Am0k-GIT/Falcon/Hardware/BOM_Falcon.csv

Name | Designator | Footprint | Quantity
 | Inductors:
1uH | L101,L104,L105 | L0805 | 3
33uH | L102,L103 | IND-SMD_L7.3-W6.6 | 2
 | Capacitors:
12pF | C216,C217 | C0603 | 2
22pF | C214,C215 | C0603 | 2
10nF | C105,C110,C202,C204,C206 | C0603 | 5
100nF | C101,C102,C106,C111,C113,C115,C116,C119, C201,C203,C205,C211,C218,C401,C402,C403,C404,C405,C406,C407, C501,C502,C503,C504,C601,C602,C701,C703,C705,C707,C709 | C0603 | 31
0.1uF | C118,C702,C704,C706,C708,C710 | C0805 | 6
1uF | C120,C208,C212 | C0805 | 3
2.2uF | C209,C210 | C0805 | 2
4.7uF | C103,C104,C108,C109 | C0805 | 4
68uF | C112,C114,C207 | CASE-B 3528 | 3
220uF/16V | C107 | SMD W6.3MM | 1
100uF/35V | C711,C712,C713 | CAP-TH W6.3MM | 3
680uF/35V | C117 | CAP-TH W10.0MM | 1
 | Resistors:
100Ω | R401,R402 | 8P4R-0603 | 2
10Ω | R601,R602,R607,R609,R613,R615 | R0805 | 6
20Ω | R103,R104,R303 | R0805 | 3
100Ω | R617,R618,R701,R702,R703,R704,R705,R706,R707,R708,R709,R710, R711,R712 | R0805 | 4
470Ω | R505,R510 | R0805 | 2
510Ω | R417,R418 | R0805 | 2
1kΩ | R403,R405,R407,R409,R411,R413,R419,R503,R508,R713 | R0805 | 9
1.8kΩ | R106 | R0805 | 1
3.9kΩ | R108 | R0805 | 1
4.7kΩ | R301,R302,R511,R512 | R0805 | 4
5.1kΩ | R101,R102,R404,R406,R408,R410,R412,R414,R415,R416 | R0805 | 10
10kΩ | R201,R202,R204,R603,R604 | R0805 | 2
12kΩ | R107 | R0805 | 1
15kΩ | R504,R509 | R0805 | 2
16kΩ | R105 | R0805 | 1
20kΩ | R109 | R0805 | 1
22kΩ | R501,R502,R506,R507 | R0805 | 4
100kΩ | R605,R606,R608,R610,R611,R612,R614,R616 | R0805 | 8
1MΩ | R203 | R0805 | 1
 | Oscillators:
8M | XTAL1 | X2-SMD-5.0X3.2X1.3MM | 1
32.768K | XTAL2 | CRYSTAL-TH_BD3.0-P1.10-D0.4 | 1
 | Diodes:
SS34 | D101,D102,D103,D104 | SMA | 4
PESD3V3L1UA | D501,D502 | SOD-323 | 2
SMD LED | LED1 | LED1206 | 1
 | Transistors:
IRLML6402TRPBF | Q1 | SOT-23-3 | 1
IRF7341TRPBF | Q2 | SOP-8 | 1
IRLR024NTRLPBF | Q3,Q4,Q5 | DPAK | 3
IRLS3034PBF | Q6 | D2PAK | 1
 | Fuses:
12A | F01 | FUSE-SMD_L6.1-W2.7 | 1
2A | F02 | FUSE-SMD_L6.1-W2.7 | 1
1206-0.5A | F03 | F1206 | 1
1206-0.2A | F04 | F1206 | 1
 | Buttons:
SMD SWITCH BUTTON | RST, BOOT0 | SWITCH SMD 4X3MM 4PIN 700955694179 | 2
 | Chips:
USBLC6-2SC6 | U1 | SOT-23-6 | 1
TPS5430DDAR | U2,U3 | ESOP-8 | 2
LM1117-3.3 | U4 | LM1117-3.3 | 1
AT24C32 | U6 | SOP-8 | 1
TLP281-4 | U7,U8 | SMD-16_L10.3-W4.4-P1.27-LS7.0-BL | 2
MC33152DR2G | U10,U11 | SOIC-8 | 2
A4988 | U12,U13,U14,U15,U16 | A4988 | 5
STM32F407VET6 | U5 | LQFP-100 | 1
TPMCP6022 | U9 | SOP-8 | 1
 | Connectors:
USB-TYPE-C-16PIN | USB | TYPE-C-SMD_HX-TYPE-C-16PIN | 1
JST-XH2.54-2PINS | 12V,F0,F1 | CON-XH2.54-2PIN | 3
JST-XH2.54-4PINS | A,B,X,Y,Z | CON-XH2.54-4PIN | 5
JST-PH2.0-2PINS | PT/1,PT/2,TR/1,TR/2,TTL0,TTL1 | CON-PH2.0-2PIN | 6
JST-PH2.0-3PINS | AL,BL,FILAM.,PS_ON,XL,YL,ZL | CON-PH2.0-3PIN | 7
JST-PH2.0-4PINS | CAN,I2C,PROBE | CON-PH2.0-4PIN | 3
KF7.62-2P | PWR | CONN-TH_KF7.62-2P | 1
KF202-5.0-2P | CH0 | CONN-TH_P5.00_KF202-5.0-2P | 1
KF128-5.0-2P | CH1,CH2,CH3 | CONN-TH_P5.00_KF128-5.0-2P | 3
BH-10 | EXP1,EXP2 | BH-10_ATMEL | 2
Header-Male-1.27 2x5 | JP1,JP2,JP3,JP4,JP5 | 2X5-1.27 | 5
Header-Male-1.27 1x3 | P1,P2,P3,P4 | 1X3-1.27 | 4
Header-Male-1.27 1X4 | PROG | 1X4-1.27 | 1
