Am0k-GIT/Falcon/Hardware/BOARD_PREVIEW.pdf

## NPN NC

PWR | NPN NC

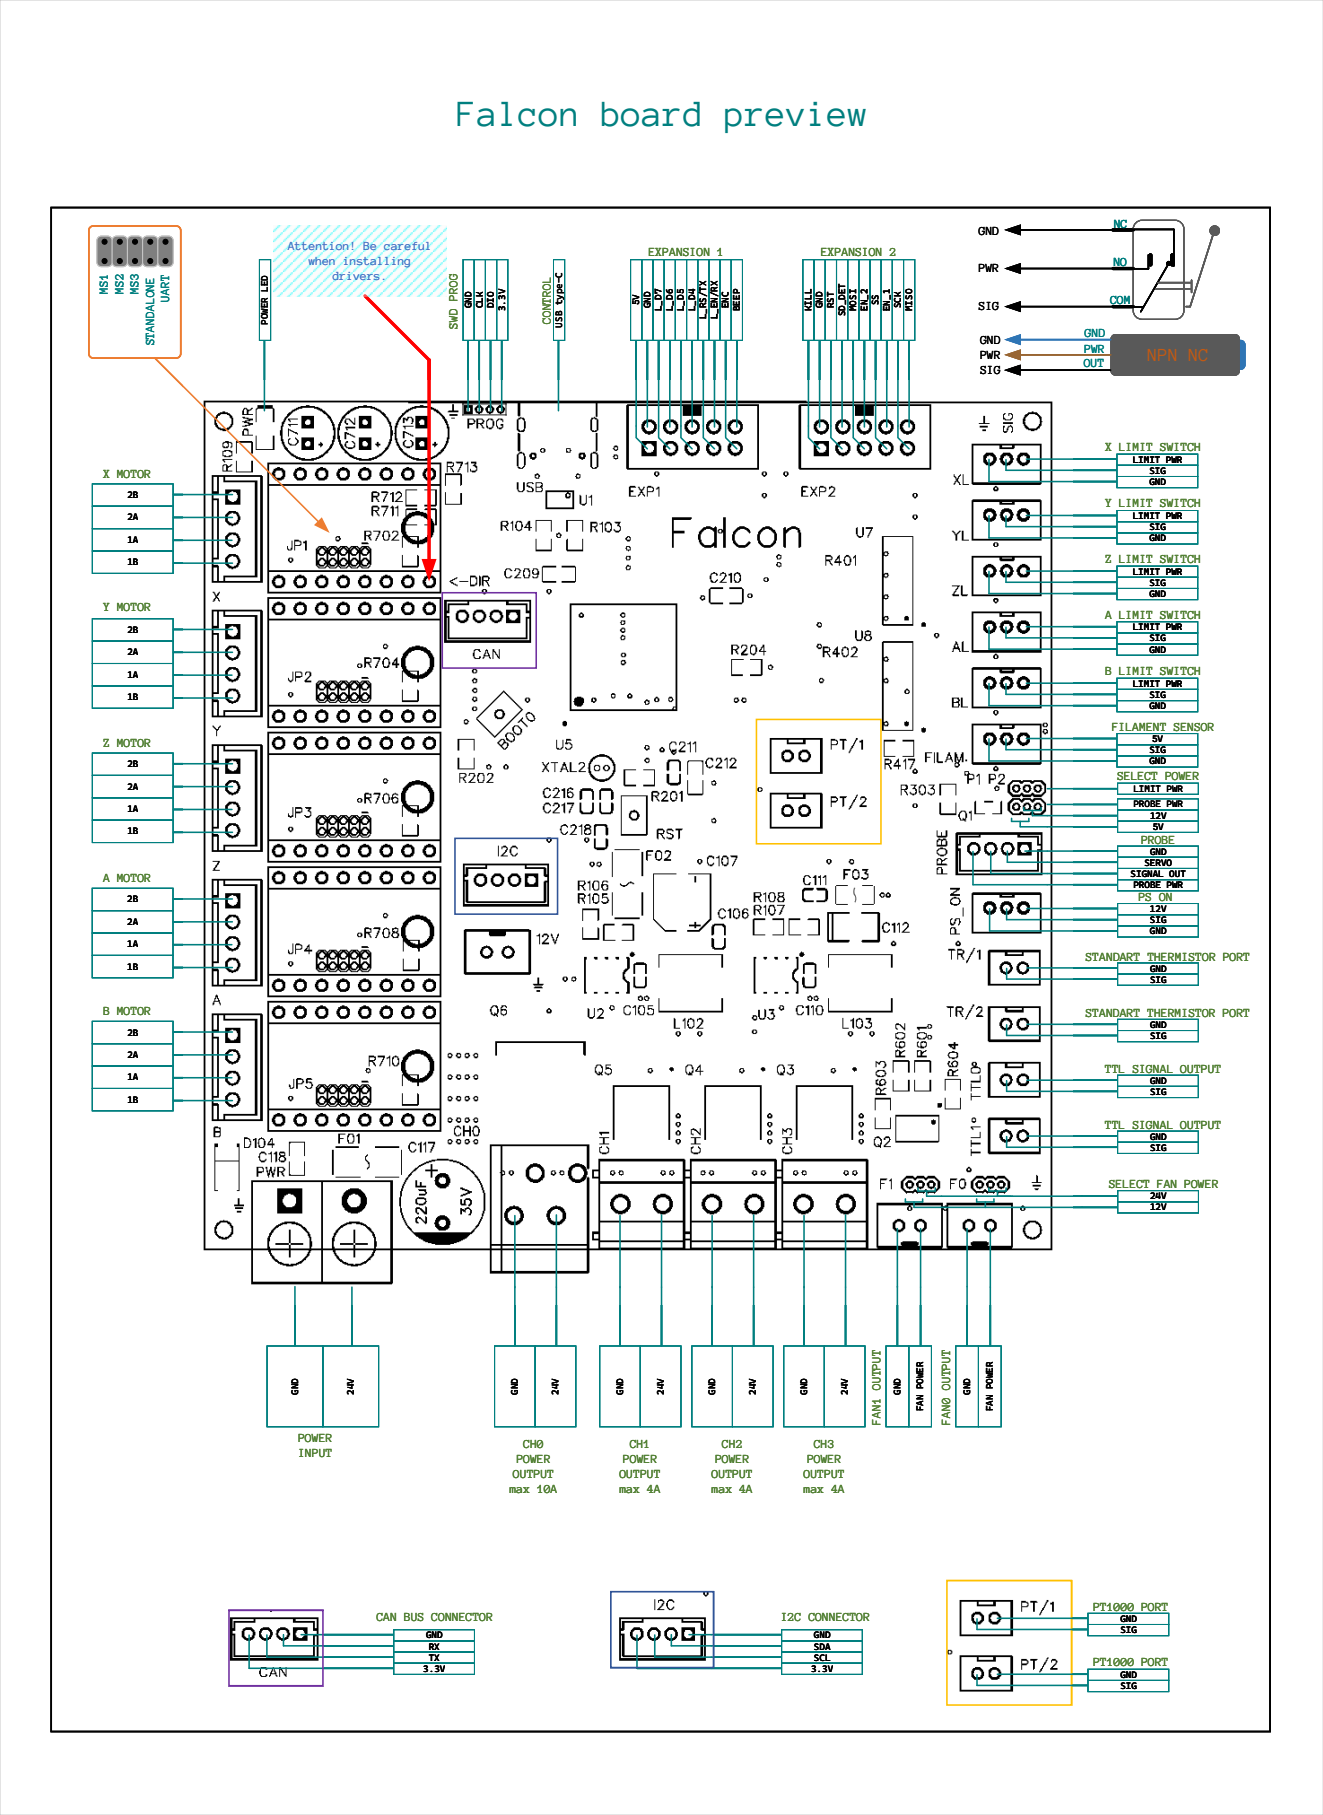
[picture p7: page 1]
GND; ENC; BEEP; KILL; RST; SD_DET; MOSI; SCK; MISO; POWER LED; CLK; DIO; USB type-C; LIMIT PWR PROBE PWR; GND SIG; 12V SIG GND; GND SERVO SIGNAL OUT PROBE PWR; 5V SIG GND; LIMIT PWR SIG GND; X LIMIT SWITCH; Y LIMIT SWITCH; Z LIMIT SWITCH; A LIMIT SWITCH; B LIMIT SWITCH; FILAMENT SENSOR; SELECT POWER; PROBE; EXPANSION 1; EXPANSION 2; CONTROL; SWD PROG; PT1000 PORT; X MOTOR; Y MOTOR; Z MOTOR; A MOTOR; B MOTOR; FAN POWER; POWER INPUT; CH0 POWER OUTPUT max 10A; CH1 POWER OUTPUT max 4A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

Falcon board preview

Attention! Be careful
when installing
drivers.

STANDART THERMISTOR PORT

TTL SIGNAL OUTPUT

SELECT FAN POWER
