Am0k-GIT/Falcon/(list of files, drawings)

Other design files:
Hardware/PCB_Falcon.json
Hardware/SCH_Falcon.json
Hardware/SCH_Falcon_2024-12-22.json
