Am0k-GIT/Falcon/(commit log)

2024-12-23 update BOARD_PREVIEW
2026-07-20 update Marlin FW
    update Marlin 2.1.2.8
